Tyomix/university-EPR/(list of files, cad)

Other CAD files:
ADC_USB/main.obj
ADC_USB/ADC_USB.obj
