Tyomix/university-EPR/ADC_USB/ADC_USB.cpp

//---------------------------------------------------------------------------

#include <vcl.h>
#pragma hdrstop
//---------------------------------------------------------------------------
USEFORM("main.cpp", Form1);
//---------------------------------------------------------------------------
WINAPI WinMain(HINSTANCE, HINSTANCE, LPSTR, int)
{
   try
   {
       Application->Initialize();
       Application->Title = "ADC USB";
                 Application->CreateForm(__classid(TForm1), &Form1);
                 Application->Run();
   }
   catch (Exception &exception)
   {
       Application->ShowException(&exception);
   }
   catch (...)
   {
       try
       {
          throw Exception("");
       }
       catch (Exception &exception)
       {
          Application->ShowException(&exception);
       }
   }
   return 0;
}
//---------------------------------------------------------------------------
